atx/mlsdr/README.md

# mlsdr
SDR for my TDOA radar project

mlsdr
