atx/mlsdr/pcb/mlaticka-sdr.step

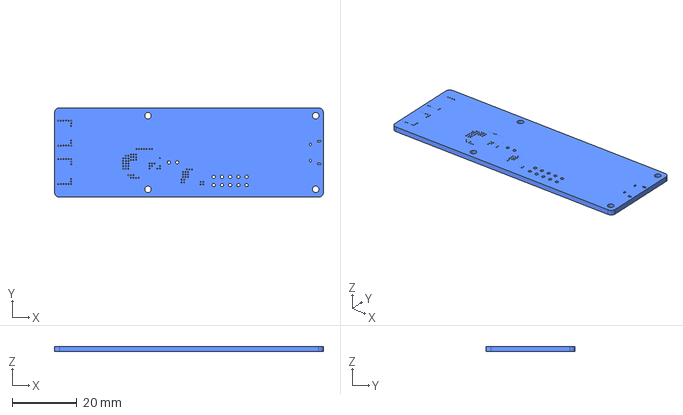
[picture p1: CAD file, 2017-07-14]
pcb/mlaticka-sdr.step
83.0 x 27.5 x 1.60 mm
