atx/mlsdr/(list of files, cad)

Other CAD files:
pcb/mlaticka_sdr.FCStd
