atx/mlsdr/pcb/mlaticka-sdr.kicad_pcb

## KiCad design pcb/mlaticka-sdr.kicad_pcb (2017-07-14)

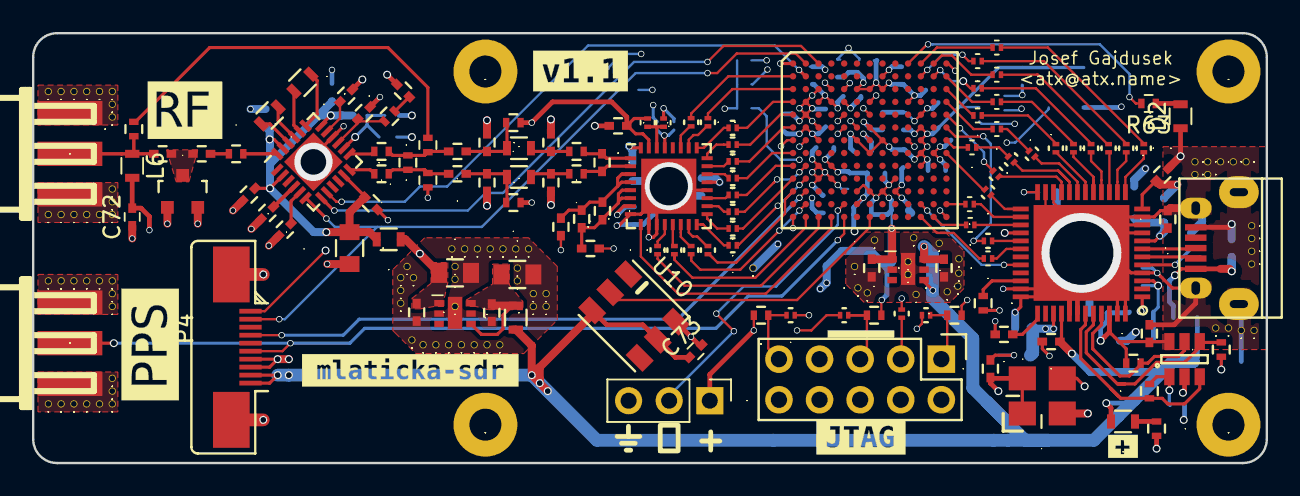
[picture p2: board mlaticka-sdr.kicad_pcb from above]

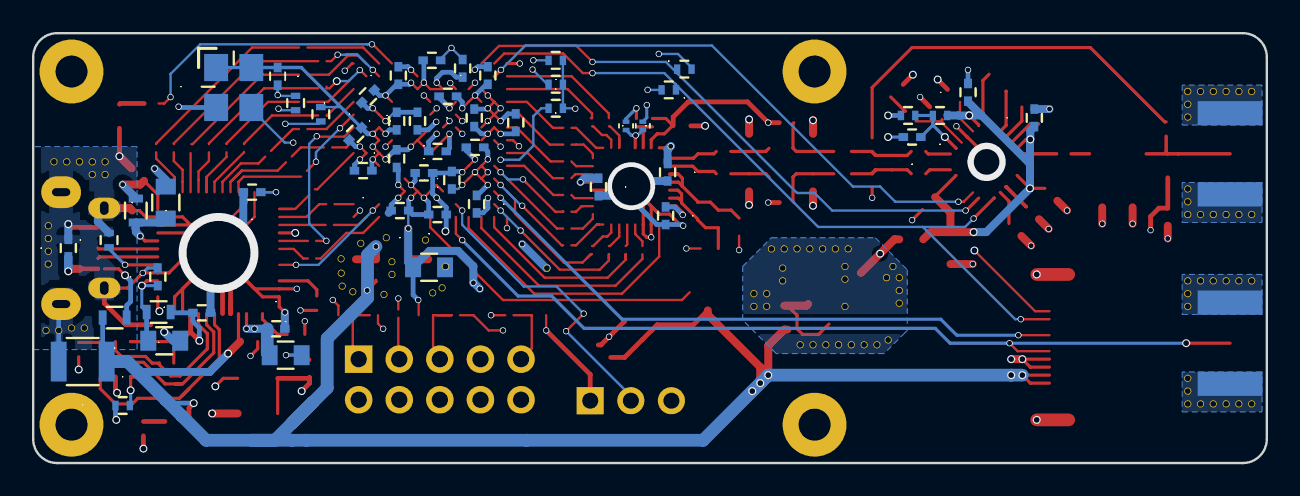
[picture p3: board mlaticka-sdr.kicad_pcb from below]

Board: 4 copper layers, 77.2 x 26.9 mm, 178 parts (54 on the bottom side), 140 nets.

Parts:
C1, C10: 330p; C_0402
C2, C18, C19, C42, C47, C51, C52: 1u; C_0402
C3, C4, C5, C6, C7, C9, C11, C12, C22, C23, C24, C25, C26, C29, C30, C31, C32, C36, C37, C38, C39, C40, C43, C44, C45, C46, C48, C49, C56, C57, C58, C59, C60, C61, C62, C63, C64, C65, C66, C67, C68, C69, C70, C71, C72, C73: 100n; C_0402
C8: 6n8; C_0402
C13, C14, C15, C16: DNP; C_0402
C17: 12p; C_0402
C20, C21: 2.2u; C_0402
C27, C54: 10n; C_0402
C28: 100u; C_1210
C33, C34, C35, C41, C50, C53, C55: 10u; C_0805
D1: LED_PWR; R_0603
D2: LED; R_0603
D3: BAV99; SOT-23
FB1: BEAD (1A); R_0603
FB2, FB3, FB4, FB5: BEAD (0.5A); R_0603
J1, J2: SMA; CON-SMA-EDGE
JP1, JP2: JMP_NO; R_0402
L1, L3: 150n; R_0603
L2: 8n2; R_0402
L4, L5: JMP; R_0603
L6: 220n; R_0603
P1: USB_OTG; USB_Micro-B
P2: JTAG; Pin_Header_Straight_2x05
P3: CONN_CLK_EXT; Pin_Header_Straight_1x03_Pitch2.54mm
P4: CONN_EXT; SFV10R
R1: 1k8; R_0402
R2, R3: 1k; R_0402
R4, R5: 25; R_0402
R6, R48: 0; R_0201
R7, R74: DNP; R_0201
R8, R9: 0; R_0402
R10, R27: DNP; R_0402
R11: 33k; R_0402
R12: 20k; R_0402
R13, R14, R15, R16, R17, R18, R19, R20, R21, R22, R23, R24, R25, R26, R36, R37, R38, R39, R40, R41, R42, R43, R44, R45, R46, R50, R51, R52, R53: 33; R_0201
R28, R29, R31, R34, R54, R55, R56, R57, R58: 10k; R_0402
R30: 2k; R_0402
R32, R33, R65, R66, R67, R68, R69, R70, R71, R72, R73: 33R; R_0201
R35: 12k; R_0402
R47, R63: R; R_0402
R49, R59, R60, R61, R62: 5k1; R_0402
U1: R820T; QFN-24_4x4mm_Pitch0.5mm_NoMask
U2: LTC22xx; QFN-32-1EP_5x5mm_Pitch0.5mm
U3: 93LC56BT; SOT-23-6
U4: FT232H; QFN-48-1EP_8x8mm_Pitch0.5mm
U5: ASFL1-12.000MHZ-EK-T; ABRACON-ASFL1
U6: 10M08SCU169; UBGA-169
U7, U8: LP5912-3.3; WSON-6-DRV
U9: ASFL1-30.000MHZ-EK-T; ABRACON-ASFL1
U10: WS2812

Connections:
3.3V_A: C23.1, C24.1, C25.1, C52.1, C53.1, FB5.1, R6.1, R74.2, U2.7, U2.21, U2.32, U8.1
3.3V_FPGA: C41.1, C43.1, C44.1, C45.1, C46.1, C47.1, C48.1, C49.1, C56.1, C57.1, C58.1, C59.1, C60.1, C61.1, C62.1, C63.1, C64.1, C65.1, C66.1, C67.1, C68.1, C69.1, C71.1, P2.4, P3.1, R49.1, R54.2, R55.1, R56.1, R57.1, R60.2, R61.2, R62.1, U6.C6, U6.C7, U6.C8, U6.D3, U6.D4, U6.D10, U6.F2, U6.F7, U6.F11, U6.G3, U6.G6, U6.G8, U6.G11, U6.H7, U6.H11, U6.J3, U6.J11, U6.K3, U6.K4, U6.K9, U6.L6, U6.L7, U6.L8, U7.1, U9.1, U9.4
+5V: C28.1, C29.1, C42.1, C72.2, C73.1, D1.2, FB1.2, FB4.1, L6.2, P4.9, P4.10, U4.40, U7.4, U7.6, U10.3, U10.5
/ADC/BYPASS: JP1.2, R27.2
/ADC/VCM: C21.1, R2.1, R3.1, R48.1, U2.31
/FPGA-Misc/TCK: P2.1, R52.2, R59.1
/FPGA-Misc/TDI: P2.9, R51.2, R61.1
/FPGA-Misc/TDO: P2.3, R50.2
/FPGA-Misc/TMS: P2.5, R53.2, R60.1
/FPGA/30Mhz: U6.G10, U9.3
/FPGA/ADC_CLK: U2.9, U6.N4
/FPGA/ADC_D0: R13.1, U6.N3
/FPGA/ADC_D1: R14.1, U6.N2
/FPGA/ADC_D2: R15.1, U6.M2
/FPGA/ADC_D3: R16.1, U6.L1
/FPGA/ADC_D4: R17.1, U6.K2
/FPGA/ADC_D5: R18.1, U6.K1
/FPGA/ADC_D6: R19.1, U6.J2
/FPGA/ADC_D7: R20.1, U6.J1
/FPGA/ADC_D8: R21.1, U6.H1
/FPGA/ADC_D9: R22.1, U6.F1
/FPGA/ADC_D10: R23.1, U6.E1
/FPGA/ADC_D11: R24.1, U6.D1
/FPGA/ADC_D12: R25.1, U6.C1
/FPGA/ADC_D13: R26.1, U6.B1
/FPGA/CLK_EXT: P3.2, U6.M5
/FPGA/EXT_P1: P4.4, U6.L2
/FPGA/FT_D0: R70.2, U6.A11
/FPGA/FT_D1: R69.2, U6.B11
/FPGA/FT_D2: R68.2, U6.A12
/FPGA/FT_D3: R67.2, U6.B12
/FPGA/FT_D4: R66.2, U6.B13
/FPGA/FT_D5: R65.2, U6.C13
/FPGA/FT_D6: R33.2, U6.D13
/FPGA/FT_D7: R32.2, U6.G13
/FPGA/FT_RST: U4.32, U6.M11
/FPGA/FT_~OE: R73.1, U4.30
/FPGA/FT_~RD: R71.1, U4.26
/FPGA/FT_~RXF: R44.1, U6.E13
/FPGA/FT_~TXE: R45.1, U6.H13
/FPGA/FT_~WR: R72.1, U4.27
/FPGA/LED_DATA: U6.N7, U10.2
/FPGA/PPS: J2.1, P4.6, U6.N5
/FPGA/SCL: P4.2, R62.2, U1.6, U6.A2
/FPGA/SDA: P4.1, R49.2, U1.7, U6.A3
/FTDI/3.3V_FT: C26.1, C31.1, C32.1, C35.1, C36.1, C39.1, C40.1, FB2.1, FB3.1, R28.1, R29.1, R31.1, R34.2, U3.6, U4.12, U4.24, U4.28, U4.39, U4.46, U5.1, U5.4
/FTDI/12MHz: U4.1, U5.3
/FTDI/CLK: R46.1, U6.F13
/FTDI/D0: R36.1, R70.1
/FTDI/D1: R37.1, R69.1
/FTDI/D2: R38.1, R68.1
/FTDI/D3: R39.1, R67.1
/FTDI/D4: R40.1, R66.1
/FTDI/D5: R41.1, R65.1
/FTDI/D6: R33.1, R42.1
/FTDI/D7: R32.1, R43.1
/FTDI/VCCA: C30.1, U4.37
/FTDI/VPHY: C33.1, C37.1, FB2.2, U4.3
/FTDI/VPLL: C34.1, C38.1, FB3.2, U4.8
/RF/3.3V: C4.1, C5.1, C7.1, C9.1, C55.1, FB5.2, R11.1, U1.2, U1.11, U1.18, U1.23
/RF/CLK: U1.8, U6.B2
/RF/IF_N: C12.2, JP2.2, R8.1, R10.1
/RF/IF_P: C11.2, JP1.1, R9.1, R10.2
GND: C2.2, C3.2, C4.2, C5.2, C6.2, C7.2, C8.2, C9.2, C10.2, C13.1, C14.2, C15.1, C16.2, C18.2, C19.2, C21.2, C23.2, C24.2, C25.2, C26.2, C27.2, C28.2, C29.2, C30.2, C31.2, C32.2, C33.2, C34.2, C35.2, C36.2, C37.2, C38.2, C39.2, C40.2, C41.2, C42.2, C43.2, C44.2, C45.2, C46.2, C47.2, C48.2, C49.2, C50.2, C51.2, C52.2, C53.2, C55.2, C56.2, C57.2, C58.2, C59.2, C60.2, C61.2, C62.2, C63.2, C64.2, C65.2, C66.2, C67.2, C68.2, C69.2, C70.2, C71.2, C72.1, C73.2, D2.1, D3.1, D3.2, J1.2, J1.3, J1.4, J1.5, J2.2, J2.3, J2.4, J2.5, JP2.1, P1.5, P1.6, P2.2, P2.10, P3.3, P4.7, P4.8, P4.11, R7.2, R12.2, R35.2, R47.2, R58.1, R59.2, U1.16, U1.25, U2.8, U2.10, U2.11, U2.20, U2.33, U3.2, U4.4, U4.9, U4.10, U4.11, U4.22, U4.23, U4.35, U4.36, U4.41, U4.42, U4.47, U4.48, U4.49, U5.2, U6.A1, U6.A13, U6.B8, U6.C3, U6.D2, U6.D5, U6.E2, U6.E11, U6.F3, U6.G7, U6.H12, U6.J4, U6.L9, U6.M6, U6.N1, U6.N13, U7.2, U7.5, U8.2, U8.5, U9.2, U10.6
unnamed: C1.1, L2.1
unnamed: C1.2, C54.1, D3.3
unnamed: C2.1, U1.4
unnamed: C3.1, U1.5
unnamed: C6.1, U1.17
unnamed: C8.1, R1.2
unnamed: C10.1, R1.1, U1.15
unnamed: C11.1, C13.2, L4.2, R2.2
unnamed: C12.1, C14.1, L5.1, R3.2
unnamed: C15.2, L4.1, R4.2
unnamed: C16.1, L5.2, R5.2
unnamed: C17.1, R4.1, U2.1
unnamed: C17.2, R5.1, U2.2
unnamed: C18.1, C20.1, C22.1, U2.3, U2.4
unnamed: C19.1, C20.2, C22.2, U2.5, U2.6
unnamed: C27.1, FB1.1, P1.1
unnamed: C50.1, C51.1, FB4.2, U8.4, U8.6
unnamed: C54.2, J1.1, L6.1, R27.1
unnamed: C70.1, R11.2, R12.1, U1.14
unnamed: D1.1, R47.1
unnamed: D2.2, R63.1
unnamed: L1.1, U1.19
unnamed: L1.2, U1.20
unnamed: L2.2, U1.24
unnamed: L3.1, U1.21
unnamed: L3.2, U1.22
unnamed: P1.2, U4.6
unnamed: P1.3, U4.7
unnamed: R6.2, R7.1, U2.29
unnamed: R8.2, U1.12
unnamed: R9.2, U1.13
unnamed: R13.2, U2.12
unnamed: R14.2, U2.13
unnamed: R15.2, U2.14
unnamed: R16.2, U2.15
unnamed: R17.2, U2.16
unnamed: R18.2, U2.17
unnamed: R19.2, U2.18
unnamed: R20.2, U2.19
unnamed: R21.2, U2.22
unnamed: R22.2, U2.23
unnamed: R23.2, U2.24
unnamed: R24.2, U2.25
unnamed: R25.2, U2.26
unnamed: R26.2, U2.27
unnamed: R28.2, R30.2, U3.1
unnamed: R29.2, U3.4, U4.44
unnamed: R30.1, U3.3, U4.43
unnamed: R31.2, U3.5, U4.45
unnamed: R34.1, U4.34
unnamed: R35.1, U4.5
unnamed: R36.2, U4.13
unnamed: R37.2, U4.14
unnamed: R38.2, U4.15
unnamed: R39.2, U4.16
unnamed: R40.2, U4.17
unnamed: R41.2, U4.18
unnamed: R42.2, U4.19
unnamed: R43.2, U4.20
unnamed: R44.2, U4.21
unnamed: R45.2, U4.25
unnamed: R46.2, U4.29
unnamed: R48.2, R74.1, U2.30
unnamed: R50.1, U6.F6
unnamed: R51.1, U6.F5
unnamed: R52.1, U6.G2
unnamed: R53.1, U6.G1
unnamed: R54.1, U6.E5
unnamed: R55.2, U6.C5
unnamed: R56.2, U6.C4
unnamed: R57.2, U6.E7
unnamed: R58.2, U6.D7
unnamed: R63.2, U6.A10
unnamed: R71.2, U6.M13
unnamed: R72.2, U6.N12
unnamed: R73.2, U6.N11
