atx/mlsdr/fpga/toplevel.v

module toplevel (
		// ADC Pins
		input wire ADC_D13,
		input wire ADC_D12,
		input wire ADC_D11,
		input wire ADC_D10,
		input wire ADC_D9,
		input wire ADC_D8,
		input wire ADC_D7,
		input wire ADC_D6,
		input wire ADC_D5,
		input wire ADC_D4,
		input wire ADC_D3,
		input wire ADC_D2,
		input wire ADC_D1,
		input wire ADC_D0,
		output wire ADC_CLK,

		// FTDI Pins
		inout wire FT_D7,
		inout wire FT_D6,
		inout wire FT_D5,
		inout wire FT_D4,
		inout wire FT_D3,
		inout wire FT_D2,
		inout wire FT_D1,
		inout wire FT_D0,
		input wire FT_nRXF,
		input wire FT_nTXE,
		output wire FT_nRD,
		output wire FT_nWR,
		output wire FT_nOE,
		input wire FT_CLK,

		input wire FT_RST,

		// Other pins
		input wire PPS,
		input wire CLK_EXT,
		input wire CLK_INT,
		inout wire SCL,
		inout wire SDA,
		output wire LED1,
		output wire LED_DATA,
		output wire TUNER_CLK
	);

	wire clk;

	pll pll (
		.inclk0(CLK_INT),
		.c0(clk)
	);

	wire ft_rst_sync;
	sync rstsync (
		.in(FT_RST),
		.out(ft_rst_sync),
		.outclk(clk)
	);
	wire nreset = !ft_rst_sync;
	assign LED1 = FT_RST;
	//wire nreset = 1;

	assign TUNER_CLK = CLK_EXT;

	wire[7:0] bus_address;
	wire[7:0] bus_data;
	wire bus_rd;
	wire bus_wr;

	wire reg_adctl_enable;
	wire[1:0] reg_adctl_mode;

	Registers registers(
		.reset(!nreset),
		.clock(clk),

		.io_bus_address(bus_address),
		.io_bus_data(bus_data),
		.io_bus_rd(bus_rd),
		.io_bus_wr(bus_wr),

		.io_adc_enable(reg_adctl_enable),
		.io_adc_mode(reg_adctl_mode)
	);

	i2c #(.BASEADDR(8'h10), .CLKDIV(250)) i2c (
		.nreset(nreset),
		.clk(clk),

		.address(bus_address),
		.data(bus_data),
		.rd(bus_rd),
		.wr(bus_wr),

		.scl(SCL),
		.sda(SDA)
	);

	wire adc_packer_valid;
	wire[11:0] adc_packer_data;

	ADCReader adcreader (
		.reset(!nreset),
		.clock(clk),
		.io_enable(reg_adctl_enable),

		.io_adc_data({ADC_D11, ADC_D10, ADC_D9, ADC_D8, ADC_D7, ADC_D6, ADC_D5,
				   ADC_D4, ADC_D3, ADC_D2, ADC_D1, ADC_D0}),
		.io_adc_clock(ADC_CLK),

		.io_out_valid(adc_packer_valid),
		.io_out_bits(adc_packer_data)
	);

	wire sawtooth_packer_valid;
	wire[11:0] sawtooth_packer_data;

	PatternSawtooth patternsawtooth (
		.reset(!nreset),
		.clock(clk),
		.io_enable(reg_adctl_enable),

		.io_out_valid(sawtooth_packer_valid),
		.io_out_bits(sawtooth_packer_data)
	);

	reg packer_valid;
	reg[11:0] packer_data;

	// TODO: Move this to a separate module or somewhere
	always @* begin
		if (reg_adctl_mode == 0) begin
			packer_valid = adc_packer_valid;
			packer_data = adc_packer_data;
		end else if (reg_adctl_mode == 1) begin
			packer_valid = sawtooth_packer_valid;
			packer_data = sawtooth_packer_data;
		end else begin
			packer_valid = 1'b0;
		end
	end

	assign LED1 = reg_adctl_mode == 1;

	wire packer_packeter_valid;
	wire[7:0] packer_packeter_data;

	Packer12to8 packer (
		.reset(!nreset),
		.clock(clk),

		.io_in_valid(packer_valid),
		.io_in_bits(packer_data),

		.io_out_valid(packer_packeter_valid),
		.io_out_bits(packer_packeter_data)
	);

	wire packeter_ftdi_valid;
	wire[7:0] packeter_ftdi_data;
	wire cmdparser_packeter_valid;
	wire[7:0] cmdparser_packeter_data;

	wire pps_synced;
	sync pssync (
		.outclk(clk),
		.in(PPS),
		.out(pps_synced)
	);

	wire ppsin_packeter_valid;
	wire[7:0] ppsin_packeter_data;

	ppsin ppsin (
		.nreset(nreset),
		.clk(clk),
		.pps(pps_synced),

		.pps_valid(ppsin_packeter_valid),
		.pps_data(ppsin_packeter_data)
	);

	assign LED2 = pps_synced;

	packeter packeter (
		.nreset(nreset),
		.clk(clk),

		.sample_valid(packer_packeter_valid),
		.sample_data(packer_packeter_data),

		.pps_valid(ppsin_packeter_valid),
		.pps_data(ppsin_packeter_data),

		.out_valid(packeter_ftdi_valid),
		.out_data(packeter_ftdi_data),

		.resp_valid(cmdparser_packeter_valid),
		.resp_data(cmdparser_packeter_data)
	);

	wire[7:0] ftdi_rddata;
	wire ftdi_rdreq;
	wire ftdi_rdempty;

	ft232 ftdi (
		.nreset(nreset),
		.clk(clk),

		.ft_clk(FT_CLK),
		.ft_nrxf(FT_nRXF),
		.ft_data({FT_D7, FT_D6, FT_D5, FT_D4, FT_D3, FT_D2, FT_D1, FT_D0}),
		.ft_noe(FT_nOE),
		.ft_nrd(FT_nRD),
		.ft_nwr(FT_nWR),
		.ft_ntxe(FT_nTXE),

		.wrreq(packeter_ftdi_valid),
		.wrdata(packeter_ftdi_data),

		.rddata(ftdi_rddata),
		.rdreq(ftdi_rdreq),
		.rdempty(ftdi_rdempty),
	);

	cmdparser cmdparser (
		.nreset(nreset),
		.clk(clk),

		.address(bus_address),
		.data(bus_data),
		.rd(bus_rd),
		.wr(bus_wr),

		.in_data(ftdi_rddata),
		.in_valid(!ftdi_rdempty),
		.in_ack(ftdi_rdreq),

		.out_valid(cmdparser_packeter_valid),
		.out_data(cmdparser_packeter_data)
	);

endmodule
