atx/mlsdr/(commit log)

2017-07-11 Initial import from the main repo
    [adc.sch, analog_psu.sch, fpga.sch, fpga_misc.sch, ftdi.sch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]
2017-07-11 fpga: Modify pins to match the v1.1 board
    Note that this intentionally breaks the build
2017-07-14 pcb: Update to the v1.1 version
    Turns out that I forgot to commit these in the old repository
    [adc.sch, analog_psu.sch, fpga.sch, fpga_misc.sch, ftdi.sch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]
2017-07-23 lib: mlsdr_sdr: Properly handle boards without r820t specified
2017-07-23 fpga: pll: Switch to the 30MHz oscillator on v1.1 board
2017-07-23 fpga: Start with chisel rewrite
    This also includes a bunch of hard-to-separate changes for the v1.1 board.
2017-07-27 fpga: Add sawtooth pattern switch
2017-07-27 lib: Warn on samples lost in the sample ring buffer
2017-07-27 lib: ring: Fix off-by-one error leading to dropped samples
2017-07-29 lib: mlsdr_test: Drop leftover debug print
2017-07-29 lib: mlsdr_test: Properly timeout and terminate if no samples arrive
2017-07-29 fpga: Move ADC divisor to Config (and calculate automatically)
2017-07-30 fpga: Rewrite the config registers in Chisel
    I2C still uses the Verilog ones, but that will hopefully change soon
2017-07-31 lib: mlsdr_test: Quick and hacky sample rate checking
